lazar2222/RISC-V-Debug/thesis/glossary.tex

\makeglossaries

\newacronym{risc}{RISC}{Reduced Instruction Set Computer}
\newacronym{fpga}{FPGA}{Field Programmable Gate Array}
\newacronym{DM}{DM}{Debug Module}
\newacronym{DTM}{DTM}{Debug Transport Module}
\newacronym{DMI}{DMI}{Debug Module Interface}
\newacronym{JTAG}{JTAG}{Joint Test Action Group}
\newacronym{ИПЦ}{ИПЦ}{Инструкције По Циклусу}
\newacronym{LE}{LE}{Logic Element}
\newacronym{PLL}{PLL}{Phase Locked Loop}
\newacronym{IDE}{IDE}{Integrated Development Environment}
\newacronym{CDT}{CDT}{C/C++ Development Tools}
\newacronym{OCD}{OCD}{On-Chip Debugger}
\newacronym{GCC}{GCC}{GNU Compiler Collection}
\newacronym{GDB}{GDB}{GNU Debugger}
\newacronym{GPIO}{GPIO}{General Purpose Input Output}
\newacronym{EXTI}{EXTI}{External Interrupt}
\newacronym{POR}{POR}{Power-on Reset}
\newacronym{DDR}{DDR}{Data Direction Register}
\newacronym{DOR}{DOR}{Data Output Register}
\newacronym{DIR}{DIR}{Data Input Register}
\newacronym{IMR}{IMR}{Interrupt Mask Register}
\newacronym{IPR}{IPR}{Interrupt Pending Register}
\newacronym{ISR}{ISR}{Interrupt Set Register}
\newacronym{RER}{RER}{Rising Edge Register}
\newacronym{FER}{FER}{Falling Edge Register}
\newacronym{IR}{IR}{Instruction Register}
\newacronym{PC}{PC}{Program Counter}
\newacronym{MSTATUS}{MSTATUS}{Machine Status}
\newacronym{MCAUSE}{MCAUSE}{Machine Cause}
\newacronym{MTVAL}{MTVAL}{Machine Trap Value}
\newacronym{MEPC}{MEPC}{Machine Exception Program Counter}
\newacronym{MIE}{MIE}{Machine Interrupt Enable}
\newacronym{MPIE}{MPIE}{Machine Previous Interrupt Enable}
\newacronym{MIP}{MIP}{Machine Interrupt Pending}
\newacronym{TCK}{TCK}{Test Clock}
\newacronym{TMS}{TMS}{Test Mode Select}
\newacronym{TDI}{TDI}{Test Data In}
\newacronym{TDO}{TDO}{Test Data Out}
\newacronym{TRST}{TRST}{Test Reset}
\newacronym{ATE}{ATE}{Automated Test Equipment}
\newacronym{TAP}{TAP}{Test Access Port}
\newacronym{DR}{DR}{Data Register}
\newacronym{DTMCS}{DTMCS}{Debug Transport Module Control and Status}
\newacronym{DMSTATUS}{DMSTATUS}{Debug Module Status}
\newacronym{DMCONTROL}{DMCONTROL}{Debug Module Control}
\newacronym{HALTSUM}{HALTSUM}{Halt Summary}
\newacronym{ABSTRACTCS}{ABSTRACTCS}{Abstract Control and Status}
\newacronym{SBCS}{SBCS}{System Bus Control and Status}
\newacronym{SBADDRESS}{SBADDRESS}{System Bus Address}
\newacronym{SBDATA}{SBDATA}{System Bus Data}
\newacronym{PROGBUF}{PROGBUF}{Program Buffer}
\newacronym{DCSR}{DCSR}{Debug Control and Status Register}
\newacronym{DPC}{DPC}{Debug Program Counter}
\newacronym{ELF}{ELF}{Executable and Linkable Format}
\newacronym{DWARF}{DWARF}{Debugging With Arbitrary Record Formats}
