lazar2222/RISC-V-Debug/thesis/bibliography.tex

\nocite{*}
\printbibliography[heading=bibintoc]

\clearpage

\printglossary[style=mcolindex,type=\acronymtype, title=Списак скраћеница, toctitle=Списак скраћеница]

\clearpage

\listoffigures

\clearpage

\listoftables

\clearpage

\lstlistoflistings
