lazar2222/RISC-V-Debug/thesis/preamble.tex

\usepackage{microtype}
\usepackage{polyglossia}
\defaultfontfeatures{Mapping=tex-text}
\setdefaultlanguage[script=Cyrillic,numerals=cyrillic-alph]{serbian}
\setotherlanguage{english}

\usepackage{csquotes}
\DeclareQuoteAlias{croatian}{serbian}
\DeclareQuoteAlias{croatian}{serbianc}
\MakeOuterQuote{"}

\newif\ifcmu
%\cmutrue
\cmufalse

\ifcmu
	\setmainfont[SmallCapsFont={CMU Serif},SmallCapsFeatures={Language=Default,Letters=SmallCaps}]{CMU Serif}
	\setsansfont{CMU Sans Serif}
	\setmonofont{CMU Typewriter Text}
\else
	\setmainfont[SmallCapsFont={Times New Roman},SmallCapsFeatures={Language=Default,Letters=SmallCaps}]{Times New Roman}
	\setsansfont{Arial}
	\setmonofont{CMU Typewriter Text}
\fi

\selectlanguage{serbian}

\setstocksize{297mm}{210mm}
\settrimmedsize{\stockheight}{\stockwidth}{*}
\setlrmarginsandblock{20mm}{20mm}{*}
\setulmarginsandblock{30mm}{30mm}{*}
\setheadfoot{\onelineskip}{2\onelineskip}
\setheaderspaces{*}{*}{*}
\settypeoutlayoutunit{mm}
\checkandfixthelayout

\SingleSpacing

\makechapterstyle{etf}{
	\chapterstyle{section}
	\renewcommand*{\chapnumfont}{\normalfont\LARGE\bfseries}
	\renewcommand*{\chaptitlefont}{\normalfont\LARGE\bfseries}
}
\chapterstyle{etf}
\setsecheadstyle{\normalfont\large\bfseries}
\setsubsecheadstyle{\normalfont\normalsize\bfseries}
\setsecnumdepth{subsection}

\newlength\fntht
\newcommand*{\size}[2][1.2]{
\setlength\fntht{#2}
\fontsize{\fntht}{#1\fntht}
\selectfont}

\usepackage{wrapfig}
\usepackage{enumitem}
\usepackage{tabularx}
\usepackage{caption}
\usepackage[table,dvipsnames]{xcolor}
\usepackage{listings}
\renewcommand{\lstlistingname}{Исечак кода}
\renewcommand{\lstlistlistingname}{Списак исечака кода}
\renewcommand{\cftchapterdotsep}{\cftdotsep}
\lstdefinelanguage{None}{}
\lstset{language=Verilog,
	basicstyle=\ttfamily\scriptsize,
	keywordstyle=\color{blue}\ttfamily,
	stringstyle=\color{Sepia}\ttfamily,
	commentstyle=\color{OliveGreen}\ttfamily,
	breaklines=true,
	frame=single,
	captionpos=b
}

\usepackage[acronym,toc,nonumberlist]{glossaries}
\usepackage{glossary-mcols}

\usepackage[unicode,xetex]{hyperref}

\usepackage[backend=biber,style=numeric,autolang=other,sorting=none]{biblatex}

\addbibresource{literatura.bib}

\usepackage{graphicx}

\graphicspath{ {./}{./img/} }

\renewcommand{\appendixpagename}{Додаци}
\renewcommand{\appendixtocname}{Додаци}

\makepagestyle{etf}
\makeevenfoot{etf}{}{}{\thepage}
\makeoddfoot{etf}{}{}{\thepage}

\copypagestyle{chapter}{plain}
\makeoddfoot{chapter}{}{}{\thepage}
\makeevenfoot{chapter}{}{}{\thepage}

\copypagestyle{part}{chapter}

\newcommand{\autor}[1]{\def\etfautor{#1}}
\newcommand{\naslov}[1]{\def\etfnaslov{#1}}
\newcommand{\datum}[1]{\def\etfdatum{#1}}
\newcommand{\mentor}[1]{\def\etfmentor{#1}}
\newcommand{\indeks}[1]{\def\etfindeks{#1}}
\newcommand{\zvanje}[1]{\def\etfzvanje{#1}}
\newcommand{\apstr}[1]{\def\etfapstr{#1}}
\newcommand{\kljucnereci}[1]{\def\etfkljucnereci{#1}}

\newcommand{\univerzitet}{Универзитет у Београду}
\newcommand{\fakultet}{Електротехнички факултет}
\newcommand{\disertacija}{Дипломски рад}
\newcommand{\grad}{Београд}
\newcommand{\mentorl}{Ментор}
\newcommand{\kandidat}{Кандидат}
\newcommand{\naslovl}{Наслов дипломског рада}
\newcommand{\rezime}{Резиме}
\newcommand{\kljucnerecil}{Кључне речи}

\newcommand{\titleF}{16pt}
\newcommand{\titleFT}{22pt}

\newcommand{\naslovna}{
\begin{DoubleSpace}
	{\clearpage
		\thispagestyle{empty}
		\centering
		{\sffamily
			{\size{\titleF} \textsc{\univerzitet}} \\
			{\size{\titleF} \textsc{\fakultet}} \\[4em]
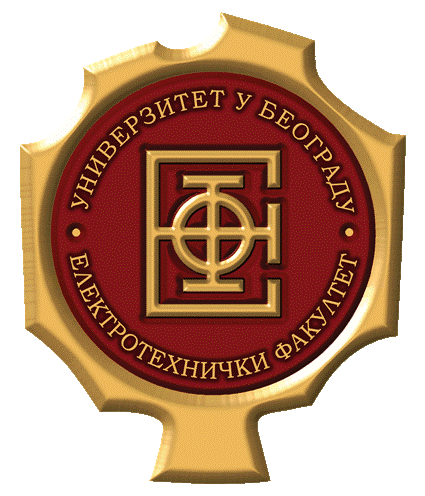
[picture p11: thesis/etf.png]
			{} \\[8em]
			{\size{\titleFT} \textbf{\textsc{\etfnaslov}}} \\
			{\size{\titleF} \disertacija}
			\vfill
			{\SingleSpacing\size{\titleF}
				\begin{tabularx}{\textwidth}{l X l}
					{\mentorl:} & & {\kandidat:} \\[0.5em]
					{\etfmentor,} & & {\etfautor} \\
					{\etfzvanje} & & {\etfindeks} \\
				\end{tabularx}
			} \\[4em]
			
			{\size{\titleF} \grad, \etfdatum.}
		}
	\clearpage}
\end{DoubleSpace}
\pagestyle{etf}
}

\newcommand{\posveta}[1]{
	{\clearpage
		\mbox{}\vspace{10em}
		\flushright
		{\size{14pt} \textit{#1}} \\
		\vfill
	\clearpage}
}

\newcommand{\apstrakt}{
	{\clearpage
		\noindent\textbf{\naslovl}: \etfnaslov \\[2em]
		\noindent\textbf{\rezime}: \etfapstr \\[2em]
		\noindent\textbf{\kljucnerecil}: \etfkljucnereci \\[1em]
	\clearpage}
}

\makecommand{\рисцв}{\textit{RISC-V} }
\makecommand{\дм}{\textit{\acrshort{DM}}}
\makecommand{\дтм}{\textit{\acrshort{DTM}}}
\makecommand{\дми}{\textit{\acrshort{DMI}}}
\makecommand{\јтаг}{\textit{\acrshort{JTAG}}}
\makecommand{\дмоде}{\textit{D}}
\makecommand{\фпга}{\textit{\acrshort{fpga}}}
