lazar2222/RISC-V-Debug/thesis/appendicies.tex

%\appendixpage
\begin{appendices}

\lstset{numbers=left, numberstyle=\tiny, stepnumber=1, numbersep=5pt}

\chapter{Управљачка јединица}\label{sec.control}
\lstinputlisting[language=Verilog,nolol=true]{listing/control.sv}

\chapter{\textit{\acrfull{DM}}}\label{sec.dm}
\lstinputlisting[language=Verilog,nolol=true]{listing/dm.sv}

\chapter{\textbf{D\_CTL}}\label{sec.dctl}
\lstinputlisting[language=Verilog,nolol=true]{listing/d_ctl.sv}

\chapter{Пример дебаговања коришћењем \textit{Eclipse Embedded CDT}}\label{sec.eclipse}
\begin{figure}[h!]
	\centering
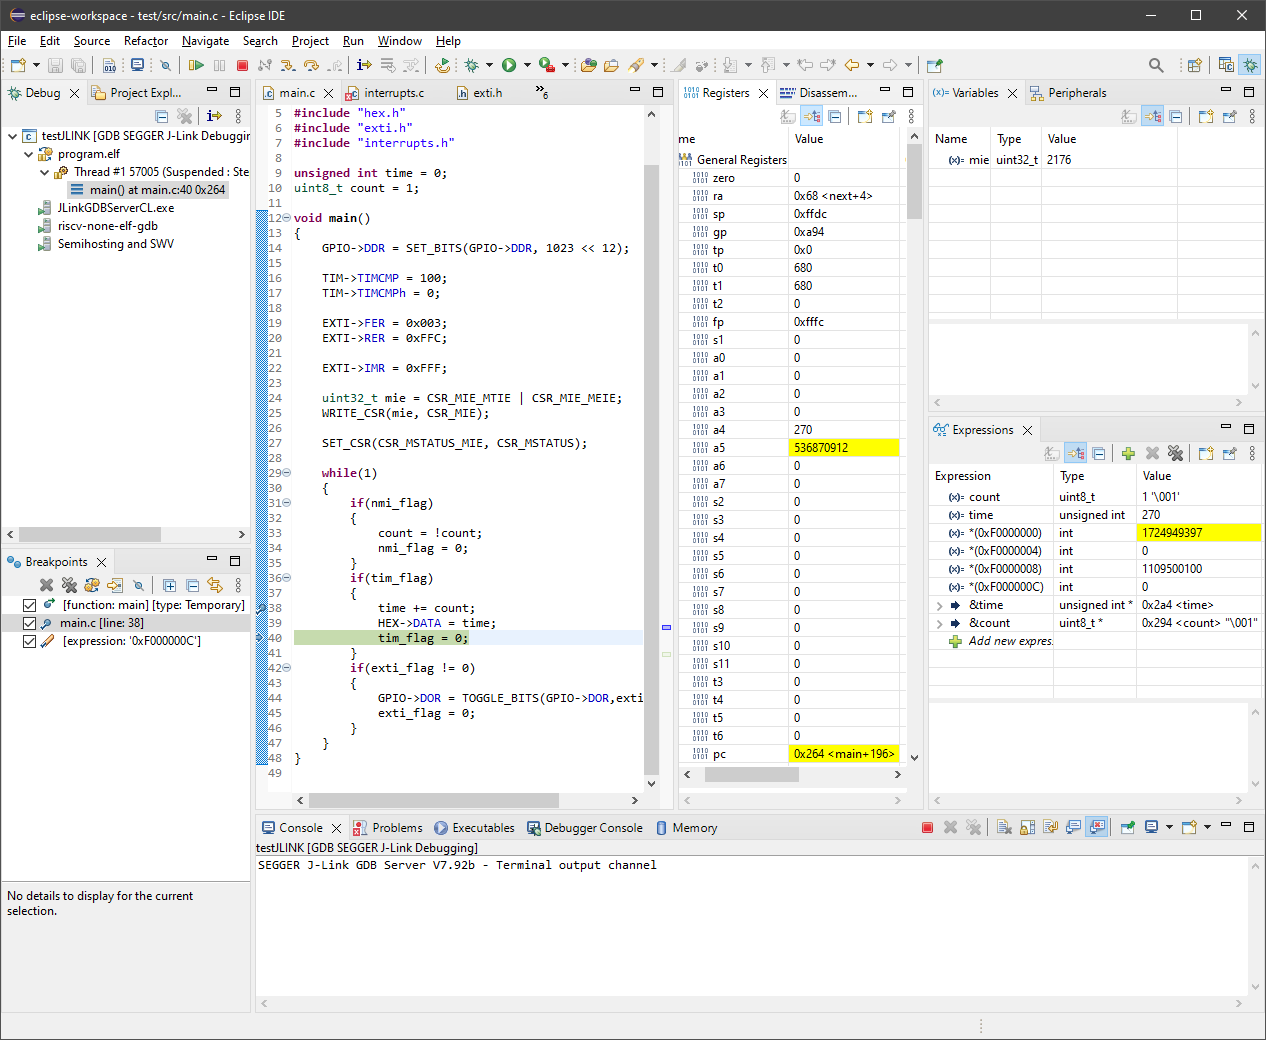
[picture p12: thesis/img/eclipse.png]
	
\end{figure}

\chapter{Скрипте коришћене за тестирање критичних функционалности}\label{chap:scr}
\lstinputlisting[language=none,nolol=true,caption=dmi\_read.do]{../simulation/dmi_read.do}
\lstinputlisting[language=none,nolol=true,caption=dmi\_write.do]{../simulation/dmi_write.do}

\lstinputlisting[language=none,nolol=true,caption=prime.do]{../simulation/prime.do}
\lstinputlisting[language=none,nolol=true,caption=primesb.do]{../simulation/primesb.do}

\lstinputlisting[language=none,nolol=true,caption=test.do]{../simulation/test.do}\newpage
\lstinputlisting[language=none,nolol=true,caption=test2.do]{../simulation/test2.do}\newpage
\lstinputlisting[language=none,nolol=true,caption=testsb.do]{../simulation/testsb.do}

\chapter{Конфигурациони фајлови за тестове \рисцв{} организације}\label{chap:conf}
\lstinputlisting[language=none,nolol=true,caption=custom.cfg]{listing/custom.cfg}
\lstinputlisting[language=none,nolol=true,caption=custom.py]{listing/custom.py}\newpage
\lstinputlisting[language=none,nolol=true,caption=custom.lds]{listing/custom.lds}

\chapter{Запис извршавања тестова \рисцв{} организације}\label{chap:sum}
\lstinputlisting[language=none,nolol=true]{listing/summary.txt}

\end{appendices}
