lazar2222/RISC-V-Debug/thesis/front.tex

\naslov{Имплементација RISC-V процесора са подршком за екстерни увид у стање процесора}
\autor{Лазар Премовић}
\indeks{2019/0091}
\datum{Септембар 2023}
\mentor{проф. др Захарије Радивојевић}
\zvanje{ванредни професор}

\naslovna
