lazar2222/RISC-V-Debug/(list of files, cad)

Other CAD files:
project/stp1.stp
