lazar2222/RISC-V-Debug/src/memory/memory.sv

`include "../system/arilla_bus_if.svh"

module memory #(
    parameter int BaseAddress,
    parameter int SizeBytes,
    parameter     InitFile,
    parameter     Hint
) (
    input clk,
    input rst_n,

    arilla_bus_if bus_interface,
    output        hit
);
    localparam int DataWidth             = $bits(bus_interface.data_ctp);
    localparam int AddressWidth          = $bits(bus_interface.address);
    localparam int BytesPerWord          = $bits(bus_interface.byte_enable);
    localparam int ByteSize              = DataWidth / BytesPerWord;
    localparam int SizeWords             = SizeBytes / BytesPerWord;
    localparam int ByteAddressWidth      = AddressWidth + $clog2(BytesPerWord);
    localparam int LocalAddressWidth     = $clog2(SizeWords);
    localparam int LocalByteAddressWidth = LocalAddressWidth + $clog2(BytesPerWord);
    localparam int DeviceAddressWidth    = AddressWidth - LocalAddressWidth;
    localparam int DeviceAddress         = BaseAddress[ByteAddressWidth-1:LocalByteAddressWidth];

    wire [DeviceAddressWidth-1:0] device_address = bus_interface.address[AddressWidth-1:LocalAddressWidth];
    wire [ LocalAddressWidth-1:0] local_address  = bus_interface.address[LocalAddressWidth-1:0];
    wire [      BytesPerWord-1:0] byte_enable    = bus_interface.byte_enable;
    wire [         DataWidth-1:0] data_in        = bus_interface.data_ctp;
    wire [         DataWidth-1:0] data_out;

    reg  read_hit;
    assign hit       = device_address == DeviceAddress;
    wire write_hit   = hit && bus_interface.write;
    wire data_enable = read_hit && !bus_interface.intercept;

    assign bus_interface.data_ptc = data_enable ? data_out : {DataWidth{1'bz}};

    always @(posedge clk) begin
        if (!rst_n) begin
            read_hit <= 1'b0;
        end else begin
            read_hit <= hit && bus_interface.read;
        end
    end

    altsyncram #(
        .byte_size                    (ByteSize),
        .numwords_a                   (SizeWords),
        .widthad_a                    (LocalAddressWidth),
        .width_a                      (DataWidth),
        .width_byteena_a              (BytesPerWord),
        .clock_enable_input_a         ("BYPASS"),
        .clock_enable_output_a        ("BYPASS"),
        .outdata_aclr_a               ("NONE"),
        .outdata_reg_a                ("UNREGISTERED"),
        .read_during_write_mode_port_a("DONT_CARE"),
        .init_file                    (InitFile),
        .lpm_hint                     (Hint),
        .lpm_type                     ("altsyncram"),
        .intended_device_family       ("Cyclone V"),
        .operation_mode               ("SINGLE_PORT"),
        .power_up_uninitialized       ("FALSE")
    ) altsyncram (
        .clock0        (clk),
        .data_a        (data_in),
        .q_a           (data_out),
        .address_a     (local_address),
        .byteena_a     (byte_enable),
        .wren_a        (write_hit),
        .rden_a        (1'b1),
        .addressstall_a(1'b0),
        .data_b        (1'b1),
        .q_b           (),
        .address_b     (1'b1),
        .byteena_b     (1'b1),
        .wren_b        (1'b0),
        .rden_b        (1'b1),
        .addressstall_b(1'b0),
        .clock1        (1'b1),
        .clocken1      (1'b1),
        .clocken0      (1'b1),
        .clocken2      (1'b1),
        .clocken3      (1'b1),
        .aclr0         (1'b0),
        .aclr1         (1'b0),
        .eccstatus     ()
    );

endmodule
