lazar2222/RISC-V-Debug/src/core/inst_decode.sv

`include "isa.svh"
`include "../debug/debug.svh"

module inst_decode (
    input [`ISA__XLEN-1:0] inst,

    input                  abstract,
    input [`ISA__XLEN-1:0] cmd,
    input [`ISA__XLEN-1:0] data0,

    output invalid_inst,

    output [`ISA__OPCODE_WIDTH-1:0] opcode,

    output [`ISA__FUNCT3_WIDTH-1:0] f3,

    output [`ISA__RFLEN-1:0] rd,
    output [`ISA__RFLEN-1:0] rs1,
    output [`ISA__RFLEN-1:0] rs2,

    output     [        `ISA__XLEN-1:0] csri,
    output reg [        `ISA__XLEN-1:0] imm,
    output reg [`ISA__FUNCT3_WIDTH-1:0] op,
    output reg                          mod,
    output                              ecall,
    output                              ebreak,
    output                              mret
);
    wire [`ISA__FUNCT7_WIDTH-1:0] f7 = `ISA__FUNCT7(inst);
    wire [        `ISA__XLEN-1:0] ii = `ISA__I_IMMEDIATE(inst);
    wire [        `ISA__XLEN-1:0] ui = `ISA__U_IMMEDIATE(inst);
    wire [        `ISA__XLEN-1:0] bi = `ISA__B_IMMEDIATE(inst);
    wire [        `ISA__XLEN-1:0] ji = `ISA__J_IMMEDIATE(inst);
    wire [        `ISA__XLEN-1:0] si = `ISA__S_IMMEDIATE(inst);

    reg  [`ISA__OPCODE_WIDTH-1:0] abstract_opcode;
    wire [        `ISA__XLEN-1:0] abstract_address = {`DEBUG__AC_REG(cmd),`DEBUG__AC_REG(cmd)};
    wire [`ISA__FUNCT3_WIDTH-1:0] abstract_f3 = (`DEBUG__AC_COMMAND(cmd) == `DEBUG__AC_COMMAND_ACCESS_MEMORY) ? `DEBUG__AC_AARSIZE(cmd) : {`DEBUG__AC_WRITE(cmd),`DEBUG__AC_REG_CSR(cmd),`DEBUG__AC_POSTEXEC(cmd)};

    always_comb begin
        abstract_opcode = {`ISA__OPCODE_WIDTH{1'b0}};
        if (`DEBUG__AC_COMMAND(cmd) == `DEBUG__AC_COMMAND_ACCESS_REGISTER) begin
           abstract_opcode = `DEBUG__AC_TRANSFER(cmd) ? `DEBUG__OPCODE_ACCESS_REG : `DEBUG__AC_POSTEXEC(cmd) ? `DEBUG__OPCODE_EXEC : `DEBUG__OPCODE_ACCESS_NA;
        end
        if (`DEBUG__AC_COMMAND(cmd) == `DEBUG__AC_COMMAND_QUICK_ACCESS) begin
            abstract_opcode = `DEBUG__OPCODE_EXEC;
        end
        if (`DEBUG__AC_COMMAND(cmd) == `DEBUG__AC_COMMAND_ACCESS_MEMORY) begin
            abstract_opcode = `DEBUG__AC_WRITE(cmd) ? `DEBUG__OPCODE_WRITE_MEM : `DEBUG__OPCODE_READ_MEM;
        end
    end

    assign opcode = abstract ? abstract_opcode                   : `ISA__OPCODE(inst);
    assign f3     = abstract ? abstract_f3                       : `ISA__FUNCT3(inst);
    assign rd     = abstract ? abstract_address[`ISA__RFLEN-1:0] : `ISA__RD(inst);
    assign rs1    = abstract ? abstract_address[`ISA__RFLEN-1:0] : `ISA__RS1(inst);
    assign rs2    = abstract ? abstract_address[`ISA__RFLEN-1:0] : `ISA__RS2(inst);
    assign csri   = abstract ? data0                             : {{`ISA__XLEN - `ISA__RFLEN{1'b0}},rs1};

    wire invalid_opcode_pfx = `ISA__OPCODE_PFX(inst) != `ISA__OPCODE_PFX_32BIT;

    wire opcode_load    = opcode == `ISA__OPCODE_LOAD;
    wire opcode_miscmem = opcode == `ISA__OPCODE_MISCMEM;
    wire opcode_opimm   = opcode == `ISA__OPCODE_OPIMM;
    wire opcode_auipc   = opcode == `ISA__OPCODE_AUIPC;
    wire opcode_store   = opcode == `ISA__OPCODE_STORE;
    wire opcode_op      = opcode == `ISA__OPCODE_OP;
    wire opcode_lui     = opcode == `ISA__OPCODE_LUI;
    wire opcode_branch  = opcode == `ISA__OPCODE_BRANCH;
    wire opcode_jalr    = opcode == `ISA__OPCODE_JALR;
    wire opcode_jal     = opcode == `ISA__OPCODE_JAL;
    wire opcode_system  = opcode == `ISA__OPCODE_SYSTEM;

    wire invalid_opcode = !
        (  opcode_load
        || opcode_miscmem
        || opcode_opimm
        || opcode_auipc
        || opcode_store
        || opcode_op
        || opcode_lui
        || opcode_branch
        || opcode_jalr
        || opcode_jal
        || opcode_system
        );

    wire invalid_branch = opcode_branch && !
        (  f3 == `ISA__FUNCT3_BEQ
        || f3 == `ISA__FUNCT3_BNE
        || f3 == `ISA__FUNCT3_BLT
        || f3 == `ISA__FUNCT3_BGE
        || f3 == `ISA__FUNCT3_BLTU
        || f3 == `ISA__FUNCT3_BGEU
        );

    wire invalid_load = opcode_load && !
        (  f3 == `ISA__FUNCT3_LB
        || f3 == `ISA__FUNCT3_LH
        || f3 == `ISA__FUNCT3_LW
        || f3 == `ISA__FUNCT3_LBU
        || f3 == `ISA__FUNCT3_LHU
        );

    wire invalid_store = opcode_store && !
        (  f3 == `ISA__FUNCT3_SB
        || f3 == `ISA__FUNCT3_SH
        || f3 == `ISA__FUNCT3_SW
        );

    wire sub_or_sra =
        (  f3 == `ISA__FUNCT3_SUB
        || f3 == `ISA__FUNCT3_SRA
        );

    wire slli_or_srli_or_srai =
        (  f3 == `ISA__FUNCT3_SLLI
        || f3 == `ISA__FUNCT3_SRLI
        || f3 == `ISA__FUNCT3_SRAI
        );

    wire valid_funct7 =
        (  (f7 == `ISA__FUNCT7_ADD)
        || (f7 == `ISA__FUNCT7_SUB && sub_or_sra)
        );

    wire valid_csr =
        (  f3 == `ISA__FUNCT3_CSRRW
        || f3 == `ISA__FUNCT3_CSRRS
        || f3 == `ISA__FUNCT3_CSRRC
        || f3 == `ISA__FUNCT3_CSRRWI
        || f3 == `ISA__FUNCT3_CSRRSI
        || f3 == `ISA__FUNCT3_CSRRCI
        );

    assign ecall =
        (  opcode_system
        && f3  == `ISA__FUNCT3_PRIV
        && rd  == `ISA__RD_ECALL
        && rs1 == `ISA__RS1_ECALL
        && ii  == `ISA__IMM_ECALL
        );

    assign ebreak =
        (  opcode_system
        && f3  == `ISA__FUNCT3_PRIV
        && rd  == `ISA__RD_ECALL
        && rs1 == `ISA__RS1_ECALL
        && ii  == `ISA__IMM_EBREAK
        );

    assign mret =
        (  opcode_system
        && f3  == `ISA__FUNCT3_PRIV
        && rd  == `ISA__RD_ECALL
        && rs1 == `ISA__RS1_ECALL
        && ii  == `ISA__IMM_MRET
        );

    wire wfi =
        (  opcode_system
        && f3  == `ISA__FUNCT3_PRIV
        && rd  == `ISA__RD_ECALL
        && rs1 == `ISA__RS1_ECALL
        && ii  == `ISA__IMM_WFI
        );

    wire invalid_jalr    = opcode_jalr    && !(f3 == `ISA__FUNCT3_JALR);
    wire invalid_opimm   = opcode_opimm   && slli_or_srli_or_srai && !valid_funct7;
    wire invalid_op      = opcode_op      && !valid_funct7;
    wire invalid_miscmem = opcode_miscmem && !(f3 == `ISA__FUNCT3_FENCE);
    wire invalid_system  = opcode_system  && !(ecall || ebreak || mret || wfi || valid_csr);

    assign invalid_inst =
        (  invalid_opcode_pfx
        || invalid_opcode
        || invalid_jalr
        || invalid_branch
        || invalid_load
        || invalid_store
        || invalid_opimm
        || invalid_op
        || invalid_miscmem
        || invalid_system
        );

    always_comb begin
        case (opcode)
            `ISA__OPCODE_JALR,
            `ISA__OPCODE_LOAD,
            `ISA__OPCODE_OPIMM,
            `ISA__OPCODE_MISCMEM,
            `ISA__OPCODE_SYSTEM: imm = ii;
            `ISA__OPCODE_LUI,
            `ISA__OPCODE_AUIPC:  imm = ui;
            `ISA__OPCODE_BRANCH: imm = bi;
            `ISA__OPCODE_STORE:  imm = si;
            `ISA__OPCODE_JAL:    imm = ji;
            default:             imm = {`ISA__XLEN{1'b0}};
        endcase
        case (opcode)
            `ISA__OPCODE_LUI,
            `ISA__OPCODE_AUIPC,
            `ISA__OPCODE_JAL,
            `ISA__OPCODE_JALR,
            `ISA__OPCODE_LOAD,
            `ISA__OPCODE_STORE: begin op = `ISA__FUNCT3_ADD; mod =  1'b0; end
            `ISA__OPCODE_OPIMM: begin op = f3;               mod =  1'b0; end
            default:            begin op = f3;               mod = f7[5]; end
        endcase
        if (abstract) begin
            imm = `DEBUG__AC_REG_CSR(cmd) ? abstract_address    : data0;
            op  = `DEBUG__AC_REG_CSR(cmd) ? `ISA__FUNCT3_CSRRWI : `ISA__FUNCT3_ADD;
            mod =  1'b0;
        end
    end

endmodule
