lazar2222/RISC-V-Debug/(commit log)

2023-08-03 project init and documentation
    [Isa_notes.xlsx]
2023-08-05 first core version
    [Isa_notes.xlsx]
2023-08-18 added support for memory interruptability
2023-08-27 cleanup yet again...
    [Isa_notes.xlsx]
2023-08-28 debug mode
    [Isa_notes.xlsx]
2023-08-30 first running program
    [stp1.stp]
2023-08-31 reset and jtag spec
    [top.sv]
2023-09-06 abstract access reg
    [stp1.stp]
2023-09-12 pre Thesis
    [hyperref.cfg]
